leaderit/rk86-ps2-kbd/README.md

# rk86-ps2-kbd
Radio 86-RK PS/2 Keyboard adapter
