leaderit/rk86-ps2-kbd/doc/key-codes.pdf

keys2

Страница

1

a

A 1C
b

B 32
c

C 21
d

D 23
e

E 24
f

F 2B
g

G 34
h
H 33 i | I | 43 j | J 3B k | K 42 l | L 4B m | M 3A n | N 31 o | O 44 p | P 4D q | Q 15 r | R 2D s | S 1B t | T 2C u | U 3C v | V 2A w | W 1D x | X 22 y | Y 35 z | Z 1A 1 | ! | 16 2 | @ 1E 3 | # | 26 4 | $ | 25 5 | % 2E 6 | ^ | 36 7 | & 3D 8 | * | 3E 9 | ( | 46 0 | ) | 45
Return | | | | | | | | | | 5A
Escape | | | | | | | | | | 76
Backspace | | | | | | | | | | 66
Tab | | | | | | | | | | 0D
Space | 29 - | _ 4E = | + | 55 [ | { | 54 ] | } | 5B \ | | | 5D

Лист2

Страница 2

RU | EN | Scan
Tab | Tab | 0D
q | Q | 15
1 | ! | 16
z | Z | 1A
s | S | 1B
a | A | 1C
w | W | 1D
2 | @ | 1E
c | C | 21
x | X | 22
d | D | 23
e | E | 24
4 | $ | 25
3 | # | 26
Space | Space | 29
v | V | 2A
f | F | 2B
t | T | 2C
r | R | 2D
5 | % | 2E
n | N | 31
b | B | 32
h | H | 33
g | G | 34
y | Y | 35
6 | ^ | 36
m | M | 3A
j | J | 3B
u | U | 3C
7 | & | 3D
8 | * | 3E
k | K | 42
i | I | 43
o | O | 44
0 | ) | 45
9 | ( | 46
l | L | 4B
p | P | 4D
- | _ | 4E
[ | { | 54
= | + | 55
Return | Return | 5A
] | } | 5B
\ | | | 5D
Backspace Backspace | 66
Escape | Escape | 76

Matrix

Страница 3

### Radio-86RK retro PC I8255 keyboard I/O Ports

4 | Recoder Input | 0 | -
5 | CC | 1 | -
6 | UC | 2 | -
7 | RUS/LAT | 3 | RUS/LAT LED

Radio-86RK keyboard matrix Main Keyboard
| PORTB A Scan bits Output
7 | 6 | 5 | 4 | 3 | 2 | 1 | 0
| 0 | Ь X | П P | Х H | Ю @ | 8 ( | 0 | TAB | Home
| 1 | Ы Y | Я Q | И I | А A | 9 ) | 1 / | LF | CLR
| 2 | З Z | Р R | Й J | Б B | : * | 2 " | CR | AR2
| 3 | Ш [ | С S | К K | Ц C | ; + | 3 # | BS | F1
| 4 | Э \ | Т T | Л L | Д D | , < | 4 $ | Left | F2
| 5 | Щ ] | У U | М M | Е E | - = | 5 % | Up | F3
| 6 | Ч ^ | Ж V | Н N | Ф F | . > | 6 & | Right | F4
| 7 | Space | В W | О O | Г Q | / ? | 7 , | Down

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
Radio-86RK keyboard matrix Special keys and I/Os

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
