leaderit/rk86-ps2-kbd/doc/5f51a14aa1d6aedb2b6d59b47264a218.png

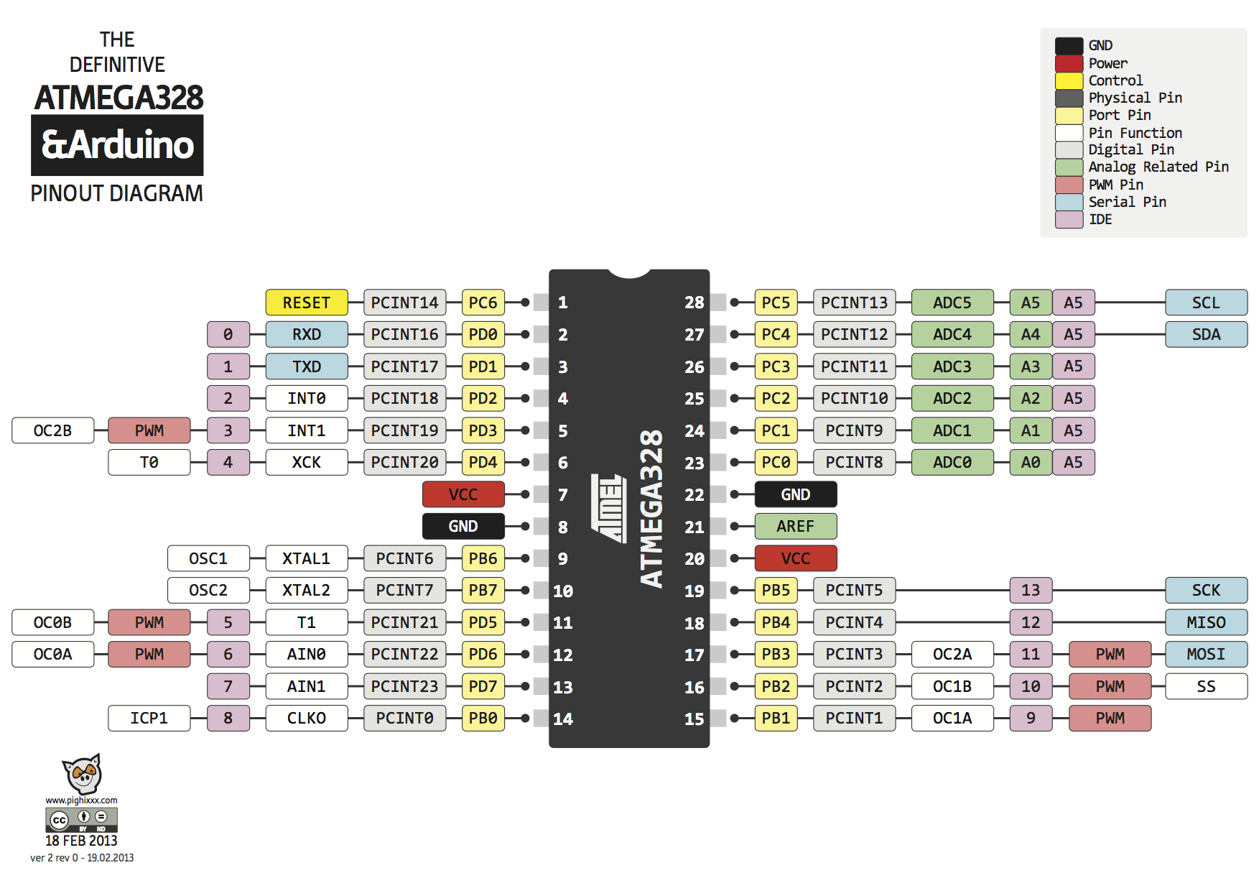
doc/5f51a14aa1d6aedb2b6d59b47264a218.png
