leaderit/rk86-ps2-kbd/doc/3179 protocol stream.jpg

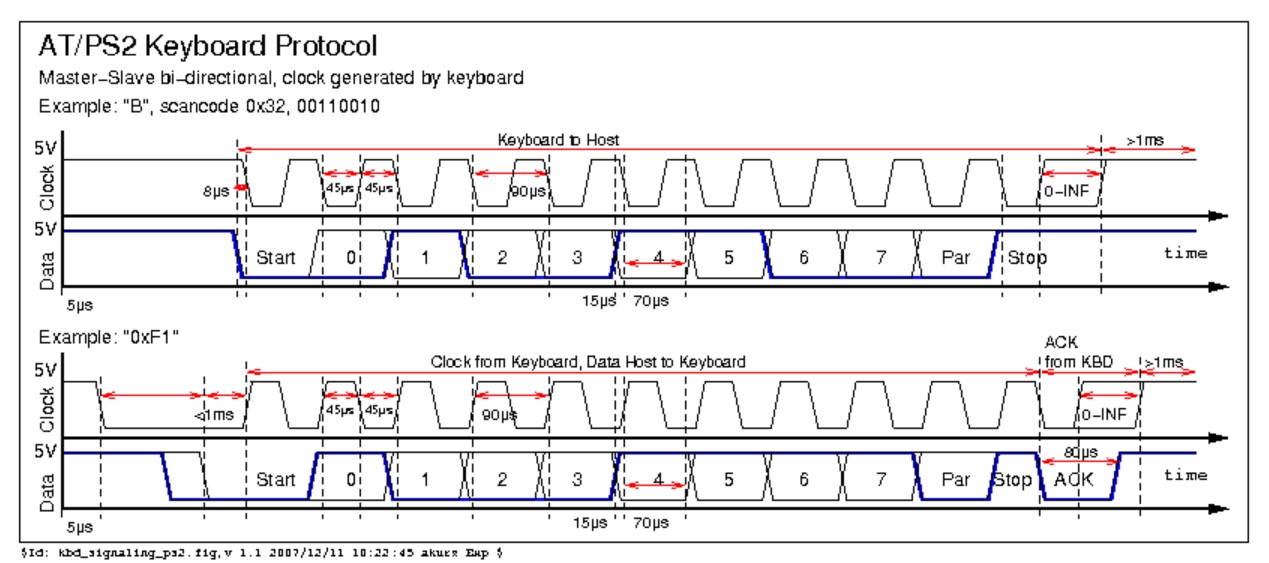
doc/3179 protocol stream.jpg
