leaderit/rk86-ps2-kbd/doc/ps2_clock_data_dev2pc01_adj.jpg

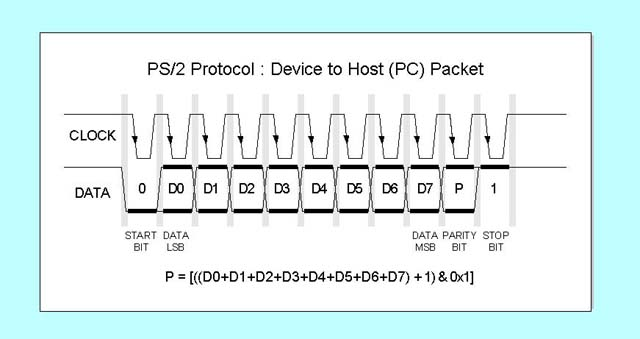
doc/ps2_clock_data_dev2pc01_adj.jpg
