leaderit/rk86-ps2-kbd/doc/PS_2_pinout.png

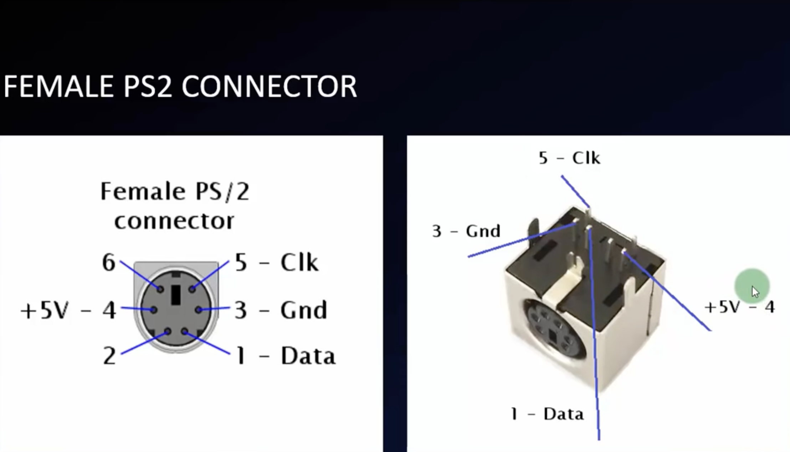
doc/PS_2_pinout.png
