leaderit/rk86-ps2-kbd/doc/waveform3.jpg

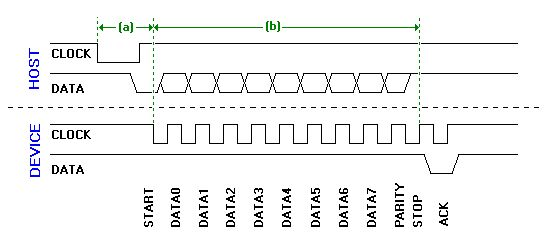
doc/waveform3.jpg
