leaderit/rk86-ps2-kbd/hardware/v3-Blue_Pill_STM32/BOM_PCB_2022-07-09.csv

ID | Name | Designator | Footprint | Quantity | Manufacturer Part | Manufacturer | Supplier | Supplier Part | Price
1 | MINI_DIN_6 | X1 | M_DIN6 | 1
2 | Radio-86RK Keyboard | H1 | HDR-TH_24P-P2.54-V-M-R2-C12-S2.54 | 1 | PZ254V-12-24P | XFCN | LCSC | C492429 | 0.132
3 | HDR-M-2.54_1x3 | J2 | HDR-M-2.54_1X3 | 1 |  |  | LCSC | C180248 | 0.163
4 | 2k | R1,R2,R3,R4,R5,R6,R7,R8,R9,R10,R11,R12,R13 | R_AXIAL-0.3 | 13
5 | STM21F103-BluePill | U1 | STM32F103-BLUEPILL | 1
6 | HDR-M-2.54_1x4 | J1 | HDR-M-2.54_1X4 | 1 |  |  | LCSC | C124378 | 0.043
