leaderit/rk86-ps2-kbd/hardware/v2-Atmega88-MT8816/Новая папка с объектами/BOM_PCB.csv

ID | Name | Designator | Footprint | Quantity | Manufacturer Part | Manufacturer | Supplier | Supplier Part | Price
1 | ATMEGA88-20PU | U2 | DIP-28_L34.6-W7.3-P2.54-LS10.2-BL | 1 | ATMEGA88-20PU | Microchip Tech | LCSC | C220850 | 5.282
2 | MINI_DIN_6 | X1 | M_DIN6 | 1
3 | HDR-M-2.54_1x4 | J3 | HDR-M-2.54_1X4 | 1 |  |  | LCSC | C124378 | 0.043
4 | X | J6 | HDR-M-2.54_2X8 | 1 |  |  | LCSC | C68234 | 0.07
5 | 2k | R1,R2,R3,R4,R5,R6,R7,R8,R9,R10,R11,R12,R13 | R_AXIAL-0.3 | 13
6 | MT8816AE | U1 | DIP40 | 1
7 | 1N4148 | D1,D2,D3,D4,D5,D6,D7,D8 | DO-35_BD2.0-L4.2-P8.20-D0.5-RD | 8 | 1N4148 | STMicroelectronics | LCSC | C13769
8 | Radio-86RK Keyboard | H1 | HDR-TH_24P-P2.54-V-M-R2-C12-S2.54 | 1 | PZ254V-12-24P | XFCN | LCSC | C492429 | 0.132
9 | Y/KEYS/LEDS | J7 | HDR-M-2.54_2X8 | 1 |  |  | LCSC | C68234 | 0.07
10 | POWER/DEBUG | J1 | HDR-M-2.54_2X3 | 1 |  |  | LCSC | C65114 | 0.031
11 | PROG | J2 | HDR-M-2.54_2X3 | 1 |  |  | LCSC | C65114 | 0.031
