leaderit/rk86-ps2-kbd/hardware/v0-no_works/Gerber_PCB_RK86-ps2keyboard/How-to-order-PCB.txt

How to Order PCB

Please refer to:
https://docs.easyeda.com/en/PCB/Order-PCB
