leaderit/rk86-ps2-kbd/hardware/KBD_Reset/PCB_PCB_KBD_Reset_2022-07-22.pdf

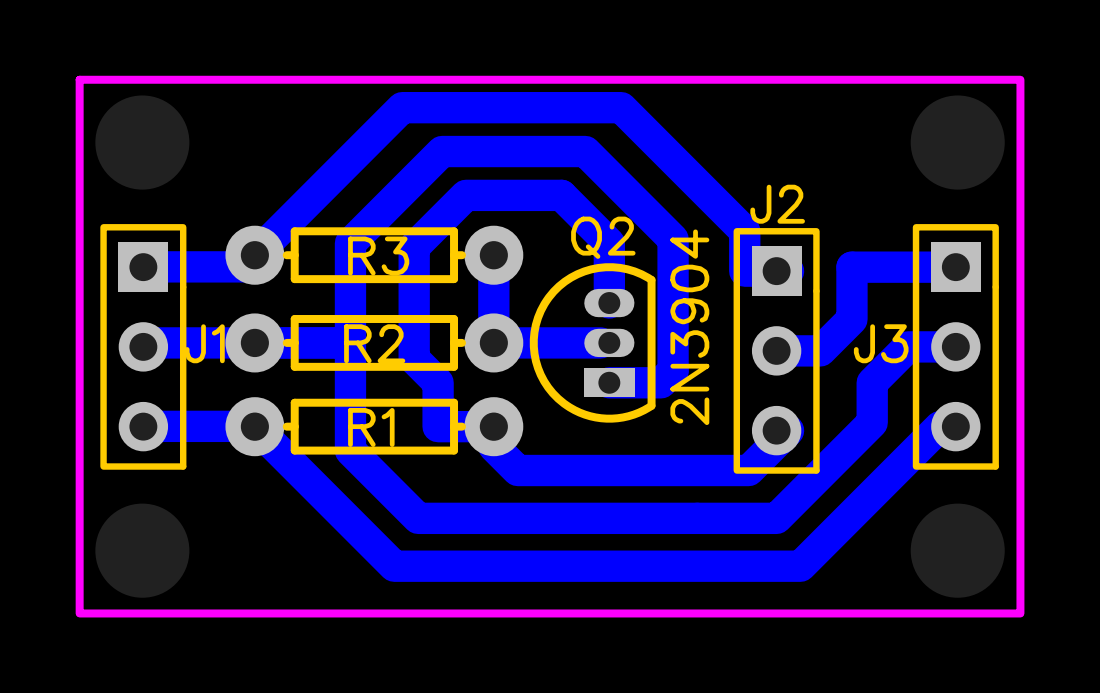
[picture p6: page 1]
