leaderit/rk86-ps2-kbd/hardware/KBD_Reset/Schematic_KBD_Reset_2022-07-22.pdf

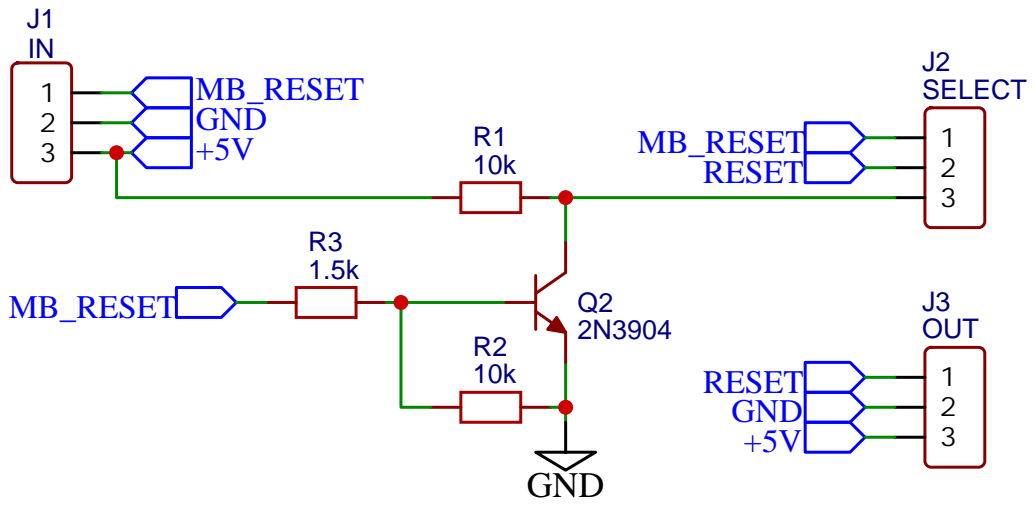
[picture p7: page 1]
