leaderit/rk86-ps2-kbd/hardware/v0-no_works/PCB_PCB_RK86-ps2keyboard_board_sides.pdf

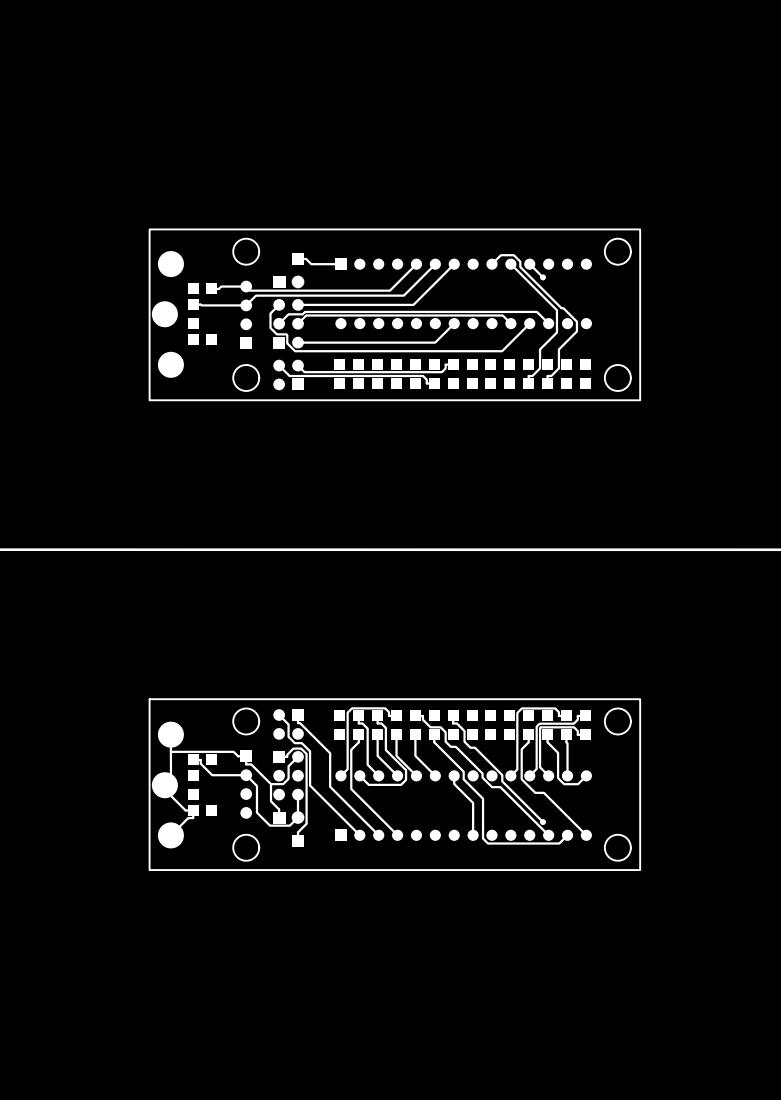
[picture p10: page 1]
