leaderit/rk86-ps2-kbd/hardware/v0-no_works/PCB_PCB_RK86-ps2keyboard_board_top.pdf

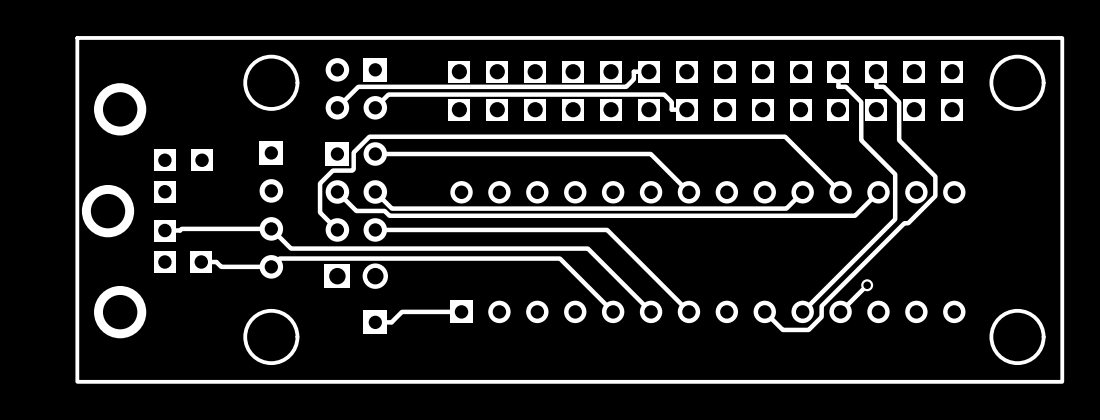
[picture p11: page 1]
