leaderit/rk86-ps2-kbd/hardware/v0-no_works/Schematic_RK86-ps2keyboard.pdf

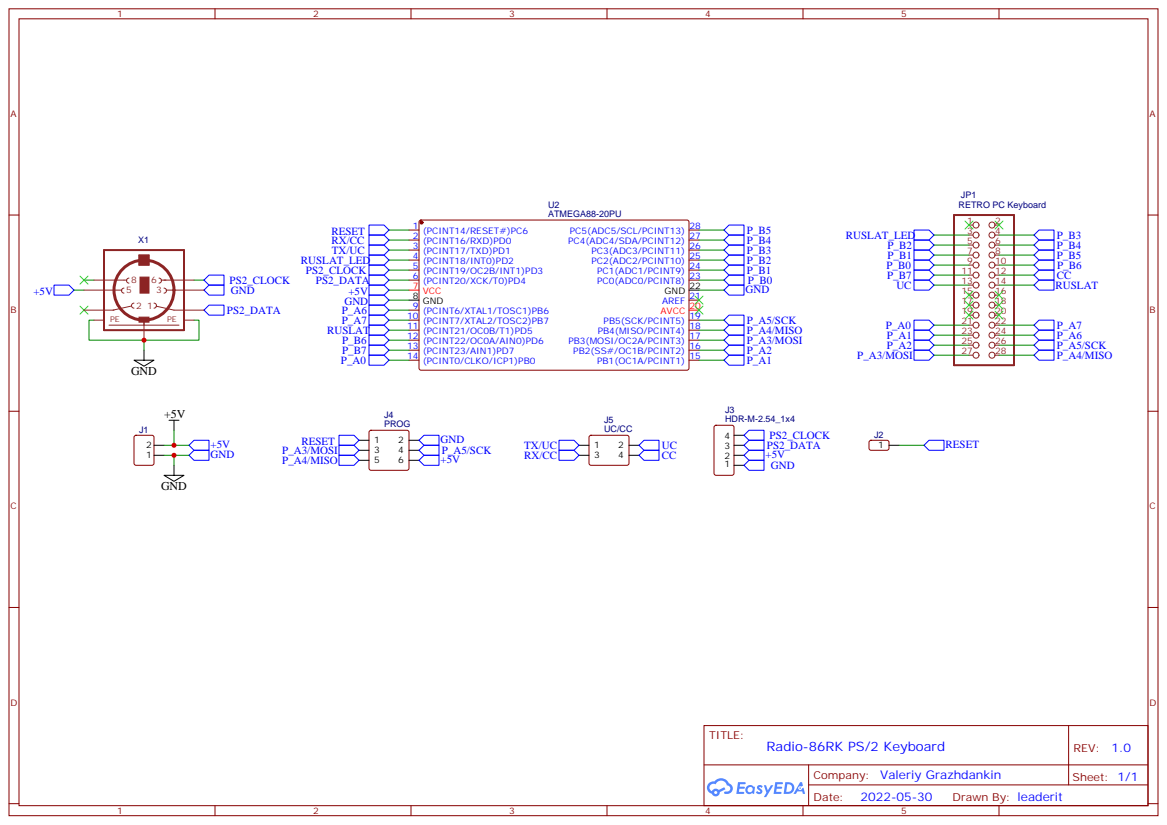
[picture p12: page 1]
