leaderit/rk86-ps2-kbd/hardware/v2-Atmega88-MT8816/PCB_PCB_2022-08-27.pdf

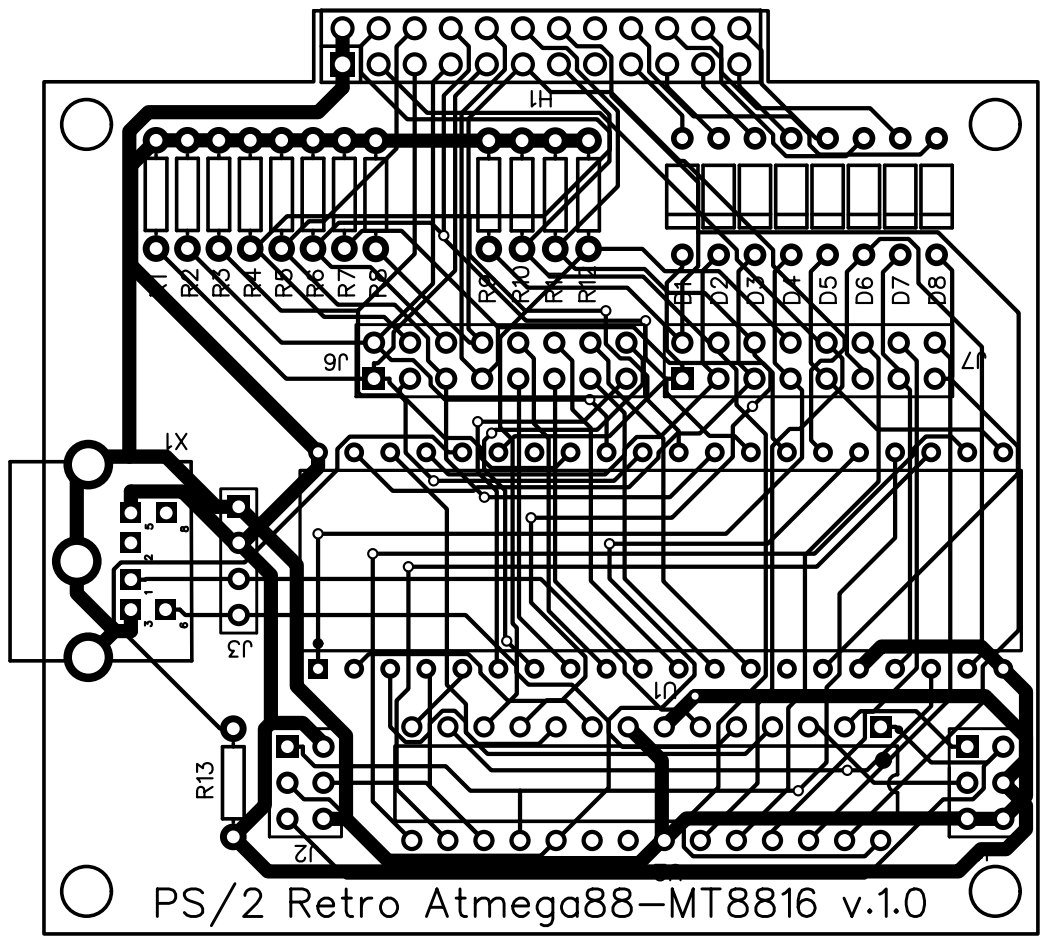
[picture p13: page 1]
