leaderit/rk86-ps2-kbd/hardware/v2-Atmega88-MT8816/Schematic_RK86-ps2keyboard-MT8816_2022-08-27.pdf

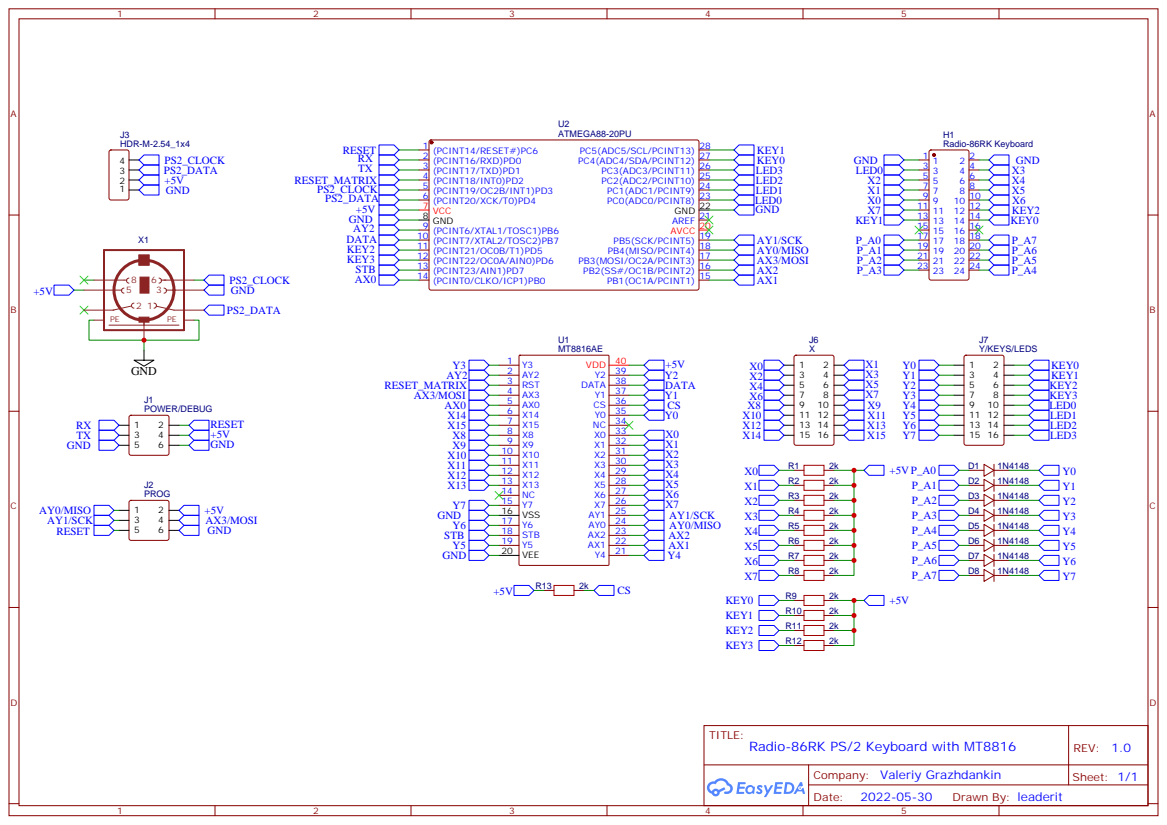
[picture p14: page 1]
