leaderit/rk86-ps2-kbd/hardware/v3-Blue_Pill_STM32/PCB.pdf

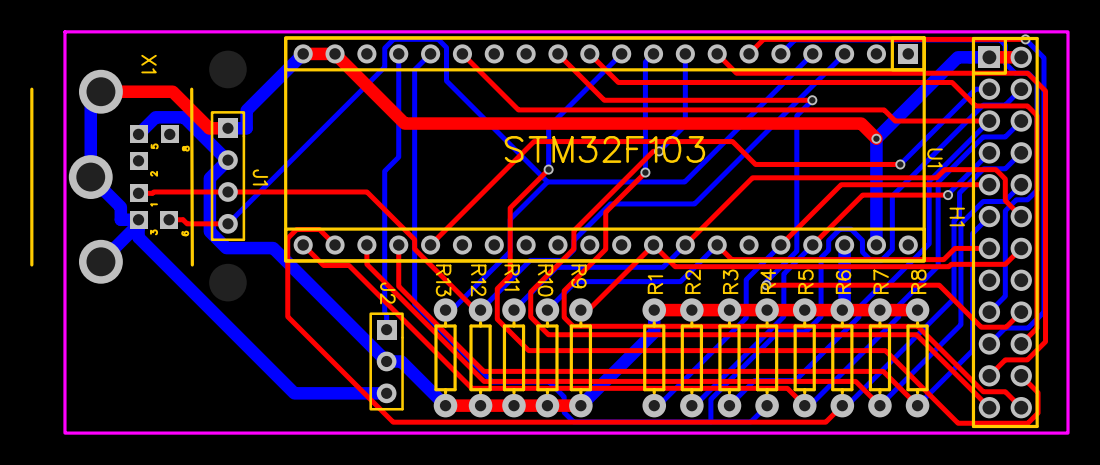
[picture p15: page 1]
