leaderit/rk86-ps2-kbd/hardware/v3-Blue_Pill_STM32/PCB_BOTTOM.pdf

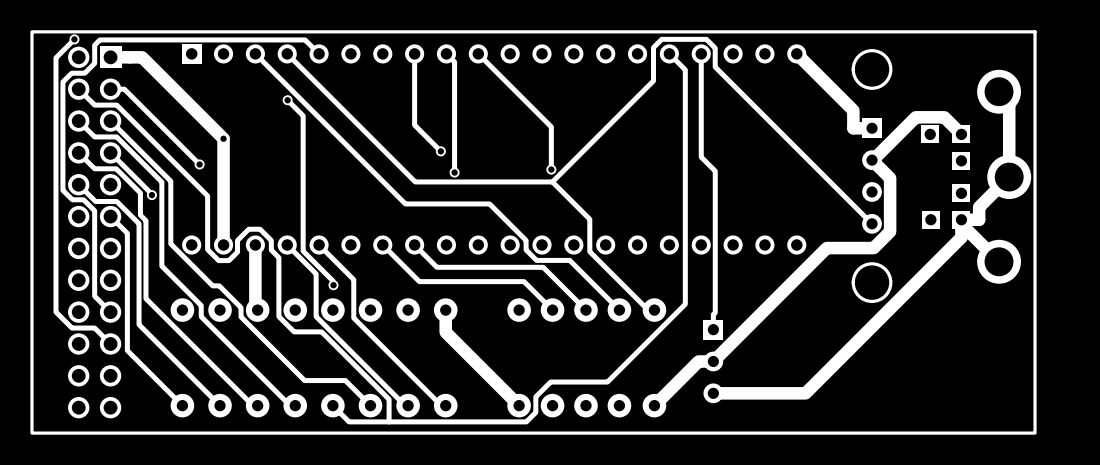
[picture p16: page 1]
