leaderit/rk86-ps2-kbd/hardware/v3-Blue_Pill_STM32/PCB_TOP.pdf

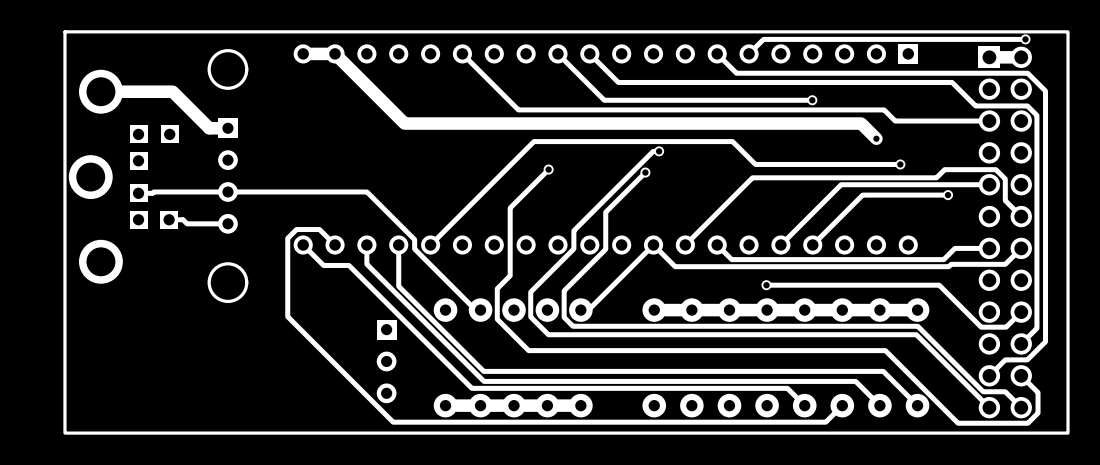
[picture p17: page 1]
