leaderit/rk86-ps2-kbd/hardware/v2-Atmega88-MT8816/Новая папка с объектами/PCB.pdf

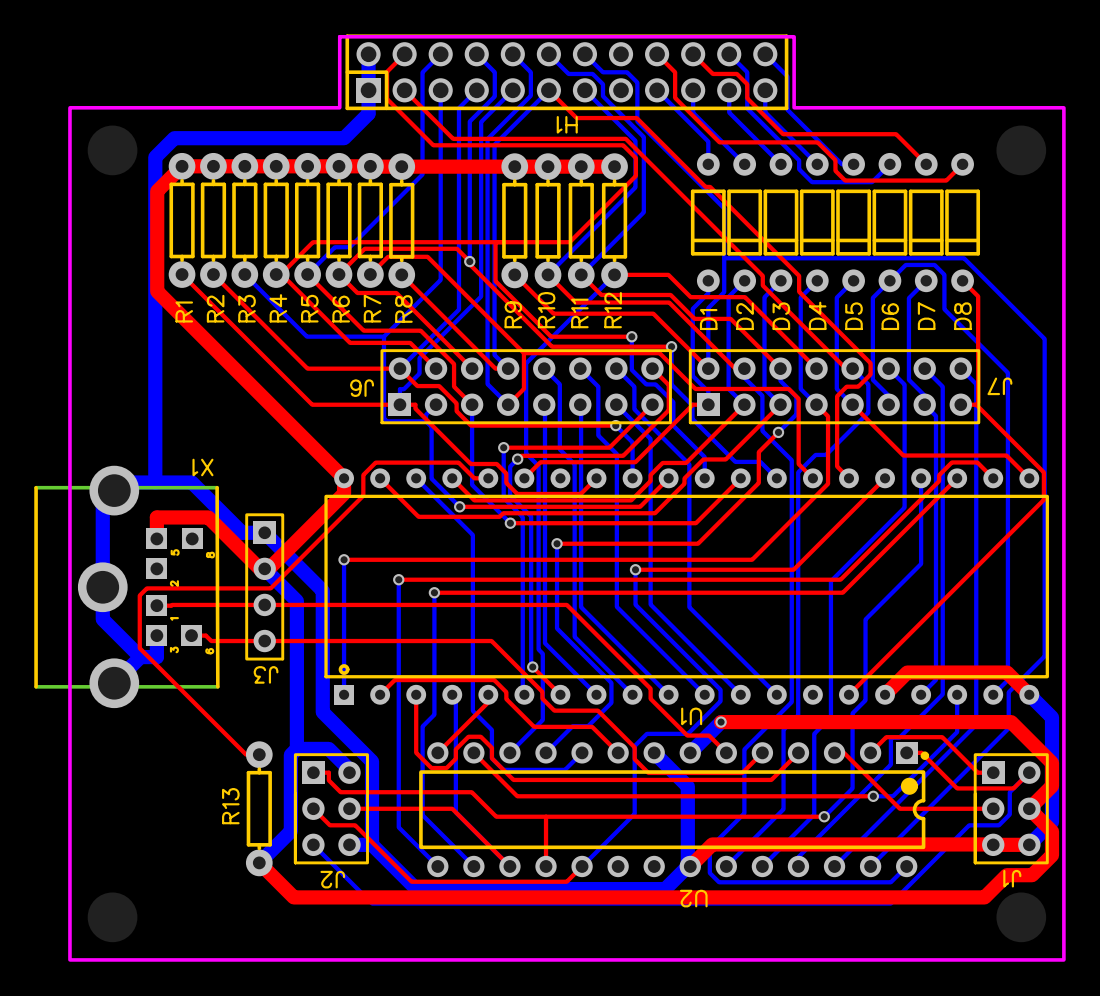
[picture p18: page 1]
