leaderit/rk86-ps2-kbd/hardware/v2-Atmega88-MT8816/Новая папка с объектами/PCB_BOTTOM.pdf

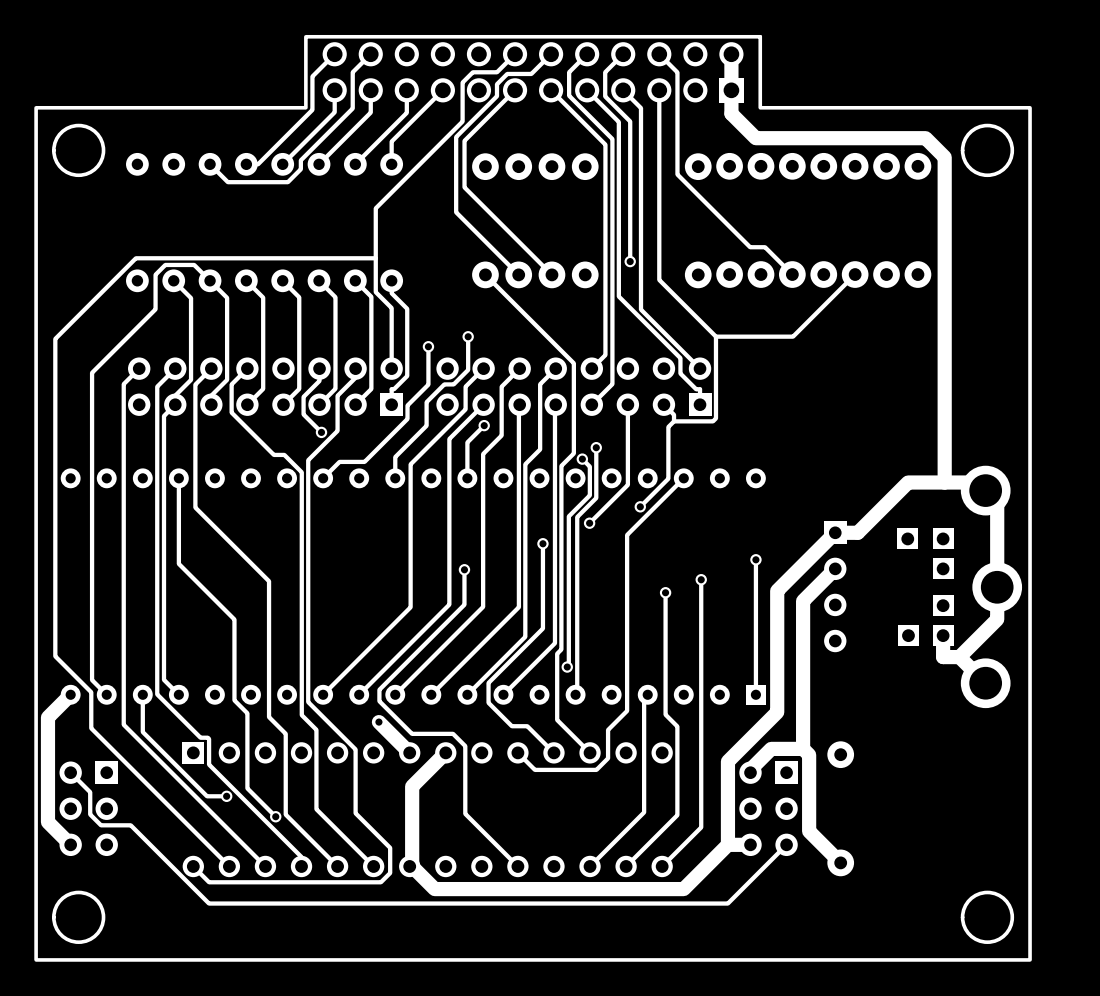
[picture p19: page 1]
