leaderit/rk86-ps2-kbd/hardware/v2-Atmega88-MT8816/Новая папка с объектами/PCB_TOP.pdf

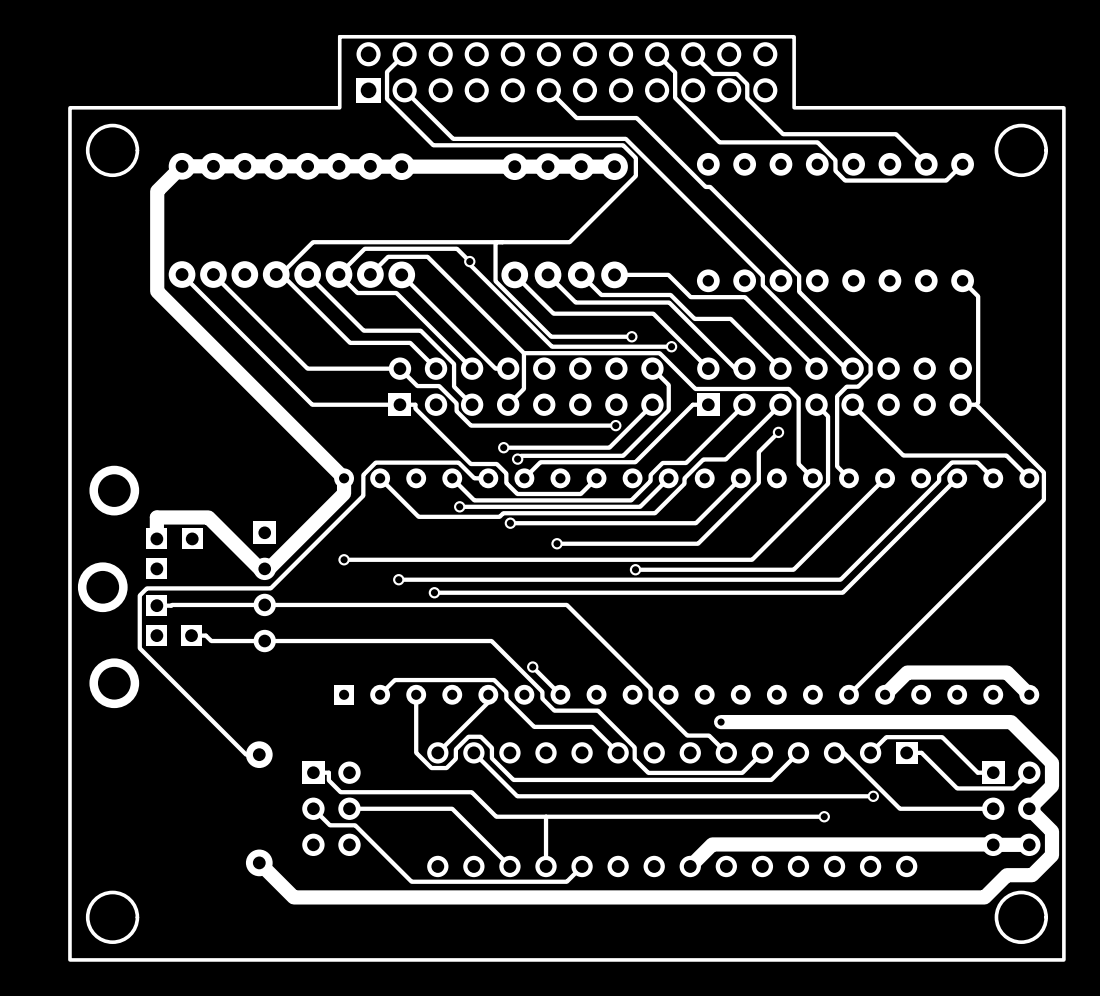
[picture p20: page 1]
