leaderit/rk86-ps2-kbd/hardware/v3-Blue_Pill_STM32/v1.1/PCB_PCB_2022-07-27.pdf

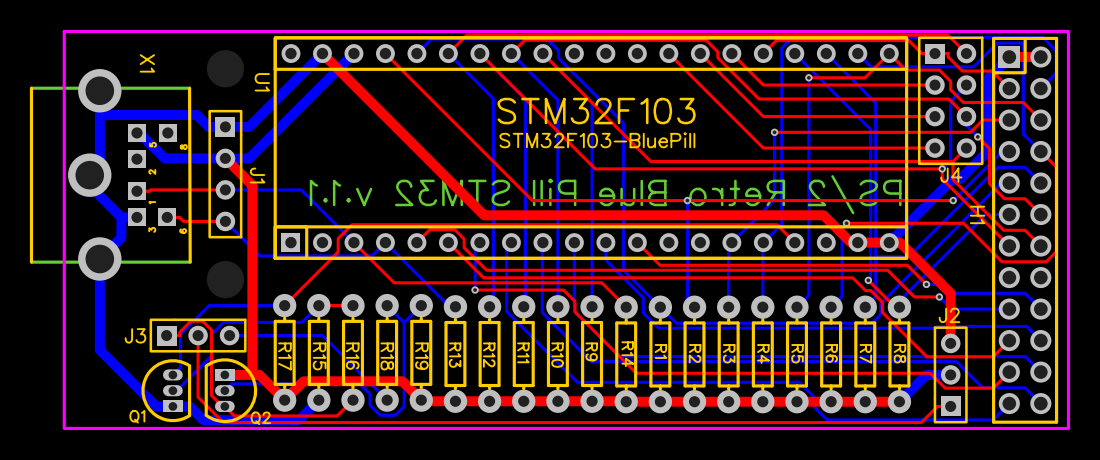
[picture p21: page 1]
