leaderit/rk86-ps2-kbd/hardware/v3-Blue_Pill_STM32/v1.1/Schematic_RK86-ps2keyboard-stm32-bluepill_2022-07-27.pdf

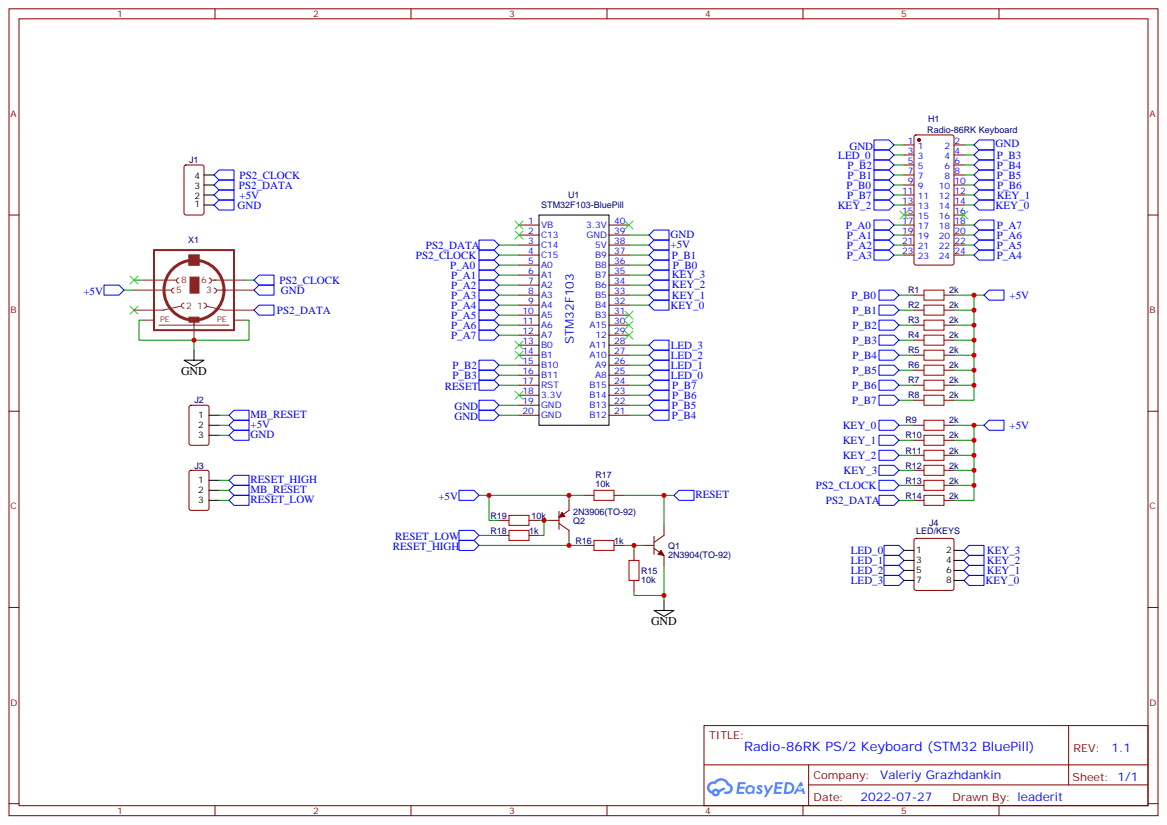
[picture p22: page 1]
