leaderit/rk86-ps2-kbd/(list of files, drawings)

Other design files:
hardware/v3-Blue_Pill_STM32/v1.1/Autorouter_PCB_2022-07-27.dsn
